Benito-0r/Self_Balancing_Robot/Fritzing Scheme.pdf

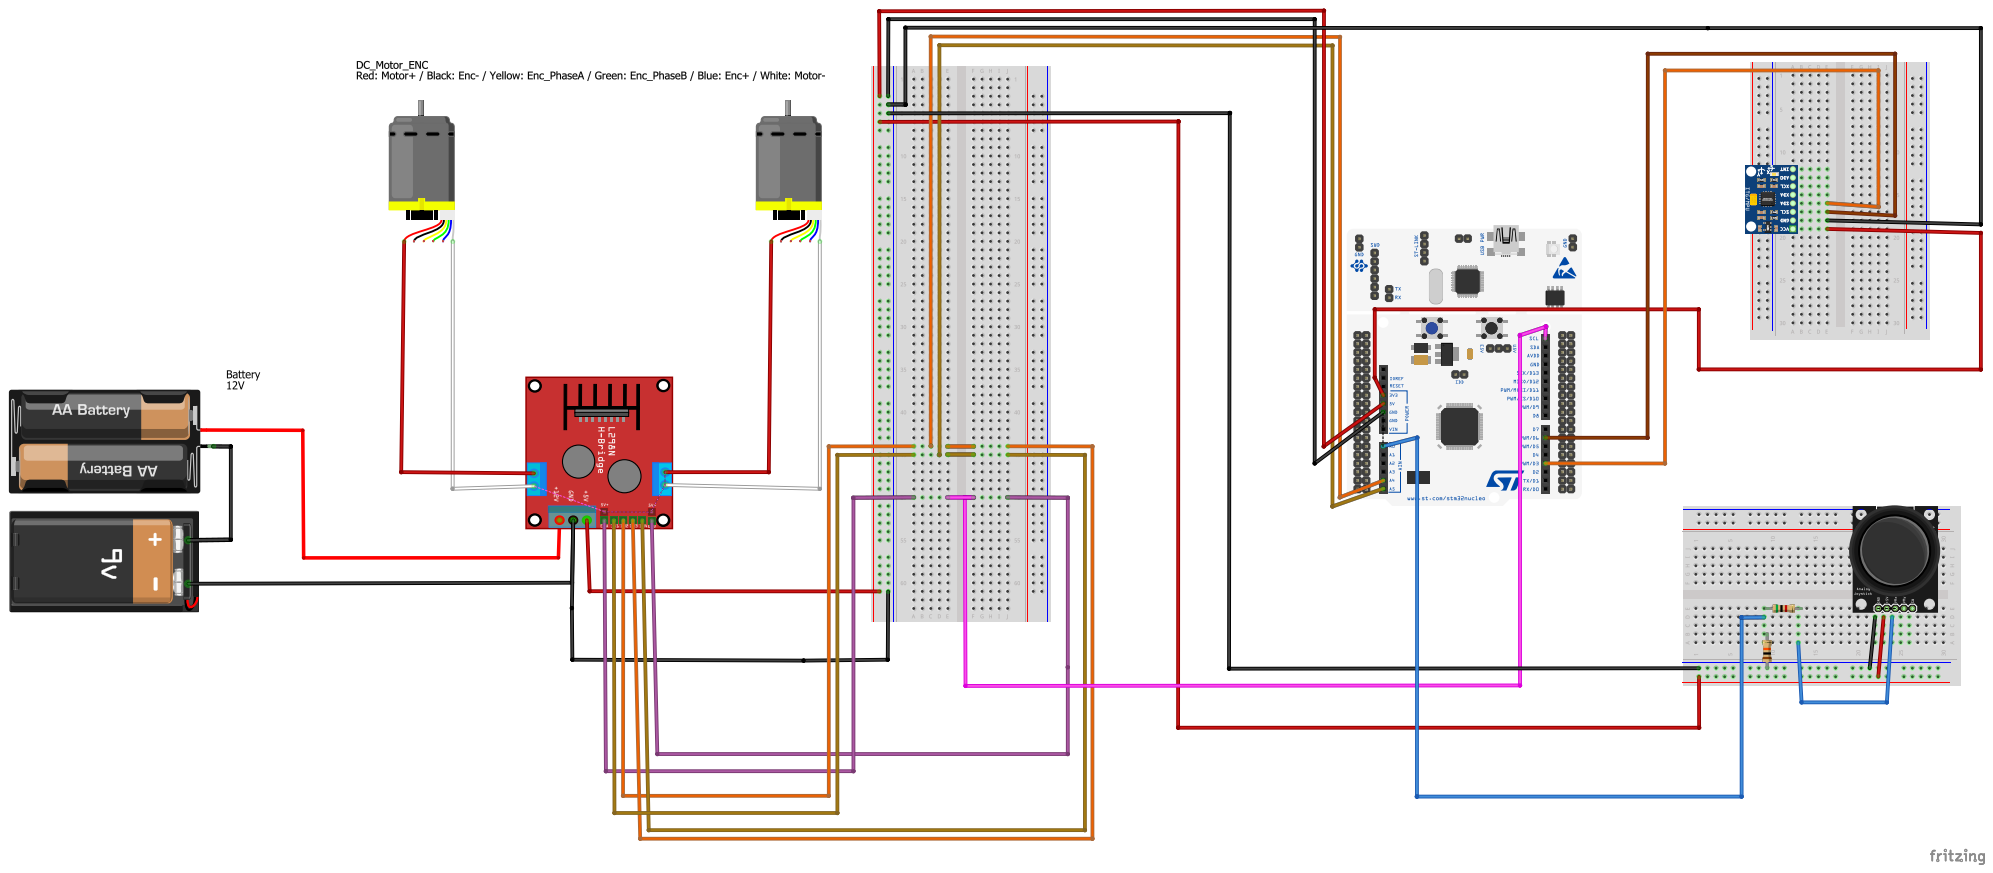
[picture p9: page 1]
