Benito-0r/Self_Balancing_Robot/SelfBalancingRobot/Core/Src/main.c

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
/* Includes ------------------------------------------------------------------*/
#include "tim.h"
#include "main.h"
#include "i2c.h"
#include "gpio.h"
#include "mpu6050.h"
#include "adc.h"
#include "dma.h"



void SystemClock_Config(void);
/**
  * @brief  The application entry point.
  * @retval int
  */
int main(void)
{
  /* MCU Configuration--------------------------------------------------------*/

  /* Reset of all peripherals, Initializes the Flash interface and the Systick. */
  HAL_Init();

  /* Configure the system clock */
  SystemClock_Config();

  /* Initialize all configured peripherals */
  MX_GPIO_Init();
  MX_DMA_Init();
  MX_ADC1_Init();
  MX_I2C2_Init();
  MX_TIM1_Init();
  MX_TIM3_Init();
  MX_TIM10_Init();
  MX_TIM11_Init();
  /* USER CODE BEGIN 2 */
	int8_t mpu_ready;
	do {
		mpu_ready = MPU6050_init();
		HAL_Delay(1000);
	} while (mpu_ready == MPU6050_ERR);
//	HAL_GPIO_WritePin(GPIOA, GPIO_PIN_5, GPIO_PIN_SET);
//	set_Gyro_offset(77, -93, -72);
	set_Gyro_offset(82, -101, -76); //Altro MPU
//	set_Gyro_offset(99, 8, 40);

	HAL_GPIO_WritePin(GPIOA, GPIO_PIN_5, GPIO_PIN_RESET);
	//insert_mpu_in_buffer(mpu);

	HAL_TIM_PWM_Start(&htim10, TIM_CHANNEL_1);
	HAL_TIM_Base_Start_IT(&htim11);
  /* USER CODE END 2 */

  /* Infinite loop */
  /* USER CODE BEGIN WHILE */
  while (1)
  {
    /* USER CODE END WHILE */

    /* USER CODE BEGIN 3 */
  }
  /* USER CODE END 3 */
}

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
