Benito-0r/Self_Balancing_Robot/SelfBalancingRobot/SelfBalancingRobot.ioc

Mcu.UserName=STM32F401RETx
PC0.Signal=GPIO_Output
PA0-WKUP.Signal=ADCx_IN0
PA9.Signal=S_TIM1_CH2
PB10.Signal=I2C2_SCL
PA5.Signal=GPIO_Output
PA8.Signal=S_TIM1_CH1
PB3.Signal=I2C2_SDA
PA6.Signal=S_TIM3_CH1
PB8.Signal=S_TIM10_CH1
PC1.Signal=GPIO_Output
PA7.Signal=S_TIM3_CH2
